yl1Ara/Ele2_smartmirror/README.md

Arttu Yli-Kujala, Aaro Esko and Eeva-Kaisa Kohonen
# ( ͡° ͜ʖ ͡°) tech. Smart Mirror

## Preview
The final_doc.pdf is the final documentation. It should be installed so all the links and \refs work

## Contribution
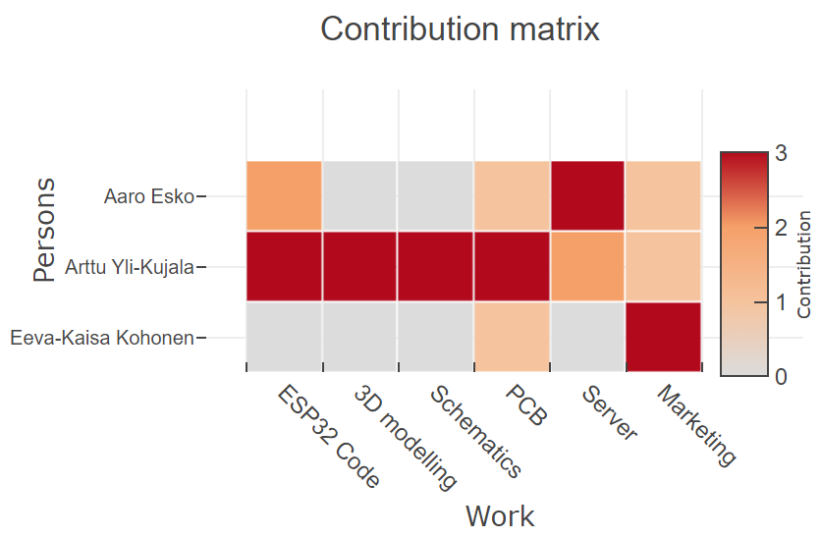
[picture p1: contributions.png]


## 3D modelling
GIF demo

## Schematics

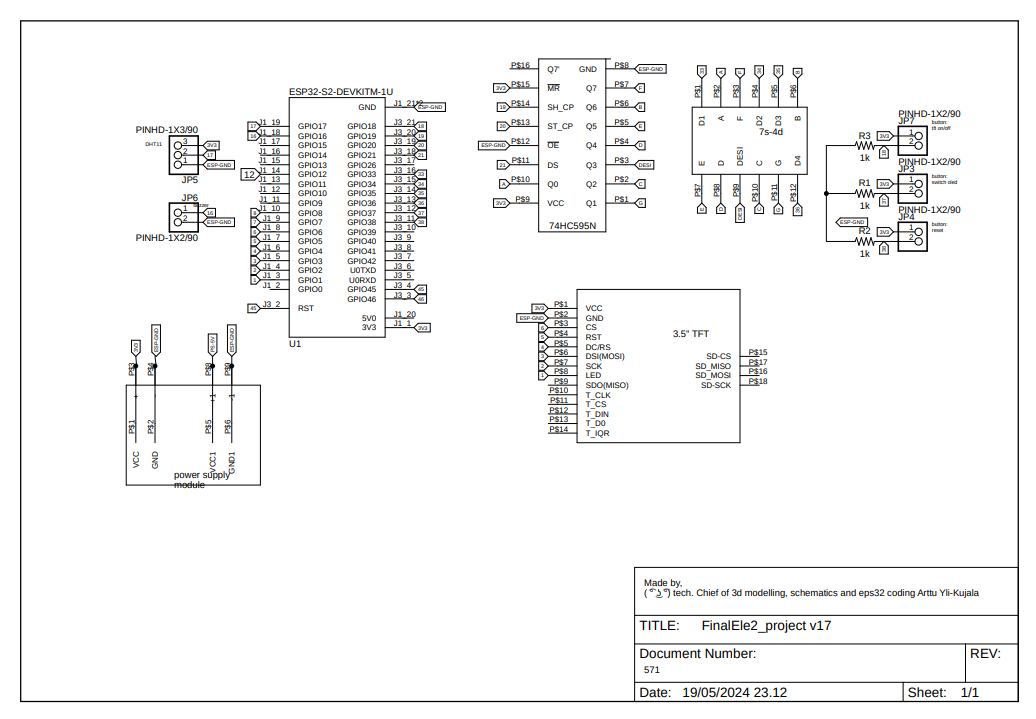
[picture p2: Schematics_and_PCB/Shematics/Schematics.png]


## PCB

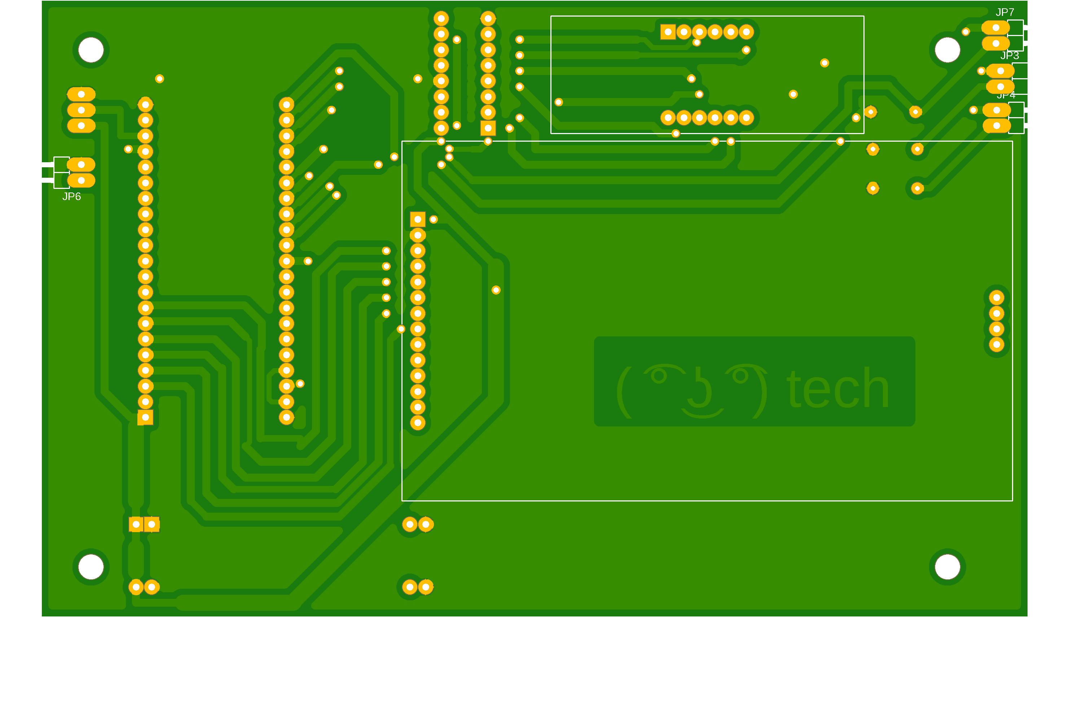
[picture p3: Schematics_and_PCB/PCB_layout/Topside.png]


## Server
