yl1Ara/Ele2_smartmirror/3Dmodel/Readme.txt

Here is included the main 3d model with all the parts that can be seen in the final product excluding wiring. These we used to make the 3d prints.

Included:
- .f3z which is the model in fusion 360 frame that includes desing and 3d animation that can be seen in the presentation,
- The .Step file looks slightly worse, but is more common and includes the same 3d model but not the animation.
- videos file consist of videos made with fusion 360 animated model presentation

Made by, 
( ͡° ͜ʖ ͡°) tech. Chief of 3d modelling, schematics and MCU coding Arttu Yli-Kujala
