yl1Ara/Ele2_smartmirror/Schematics_and_PCB/Shematics/Readme.txt

This file includes all the electronic schematics information

-.fsch is fusion 360 straight import with all the data about parts, their libraries and more info on connection and spices.
-schematics.pdf has a simple black and white picture of connections and parts
-schematics are also added in .png form

Made by, 
( ͡° ͜ʖ ͡°) tech. Chief of 3d modelling, schematics and MCU coding Arttu Yli-Kujala
