yl1Ara/Ele2_smartmirror/3Dmodel/videos/6.gif

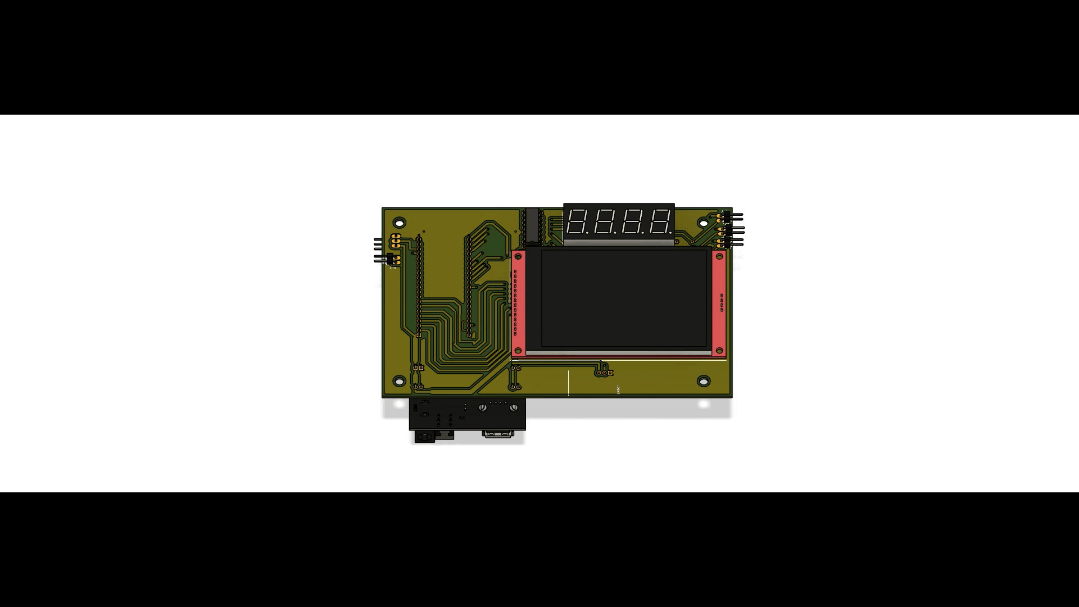
3Dmodel/videos/6.gif
