yl1Ara/Ele2_smartmirror/3Dmodel/videos/8.gif

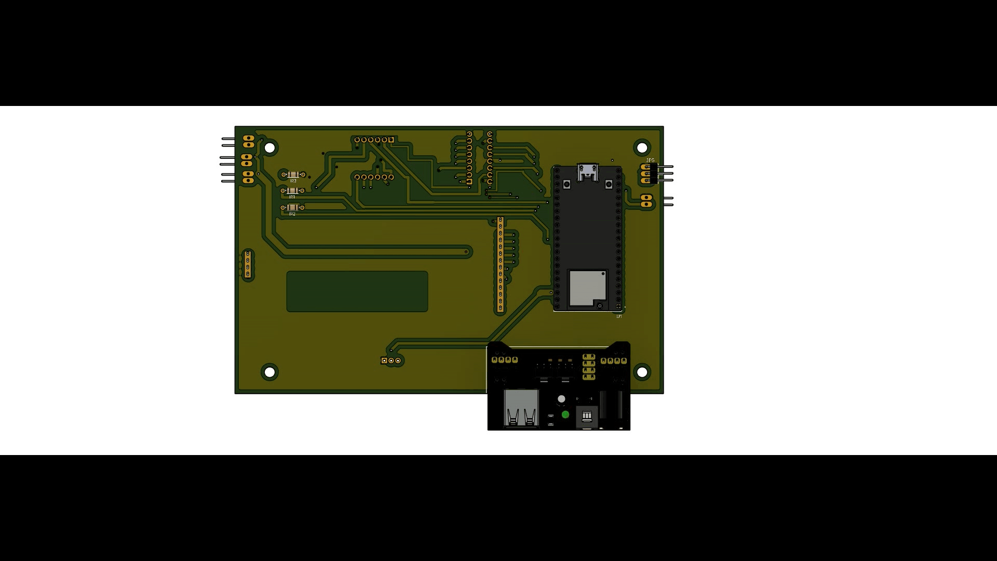
3Dmodel/videos/8.gif
