yl1Ara/Ele2_smartmirror/Schematics_and_PCB/Shematics/Schematics.pdf

3JP6

8 12

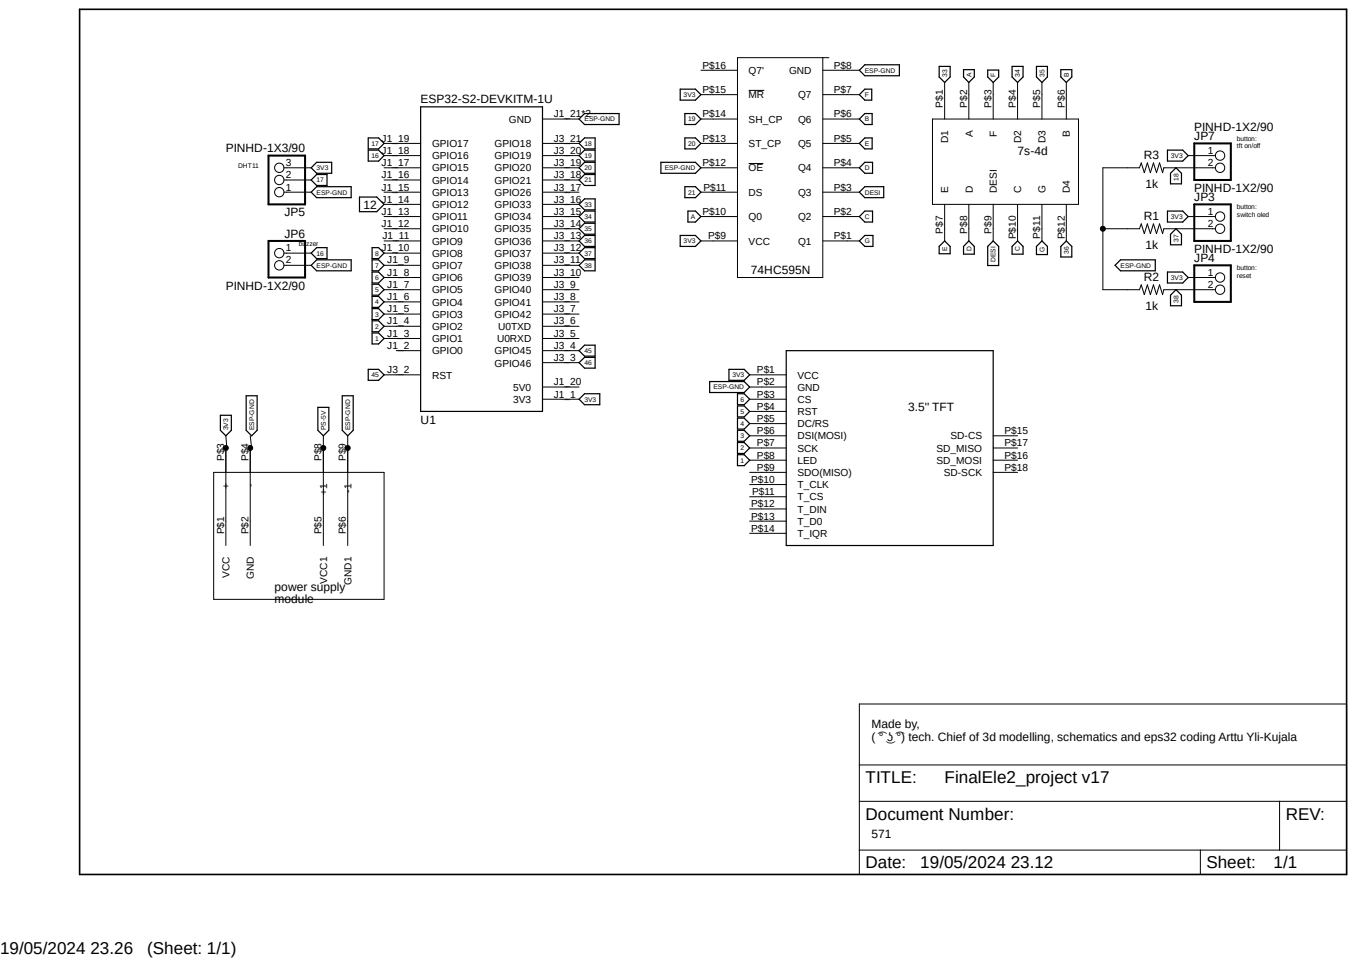
[picture p20: page 1]

Made by,
( ͡° ͜ʖ ͡°) tech. Chief of 3d modelling, schematics and eps32 coding Arttu Yli-Kujala

Document Number: 571 | REV:

Date: 19/05/2024 23.12 | Sheet: 1/1
