yl1Ara/Ele2_smartmirror/Schematics_and_PCB/PCB_layout/bot.pdf

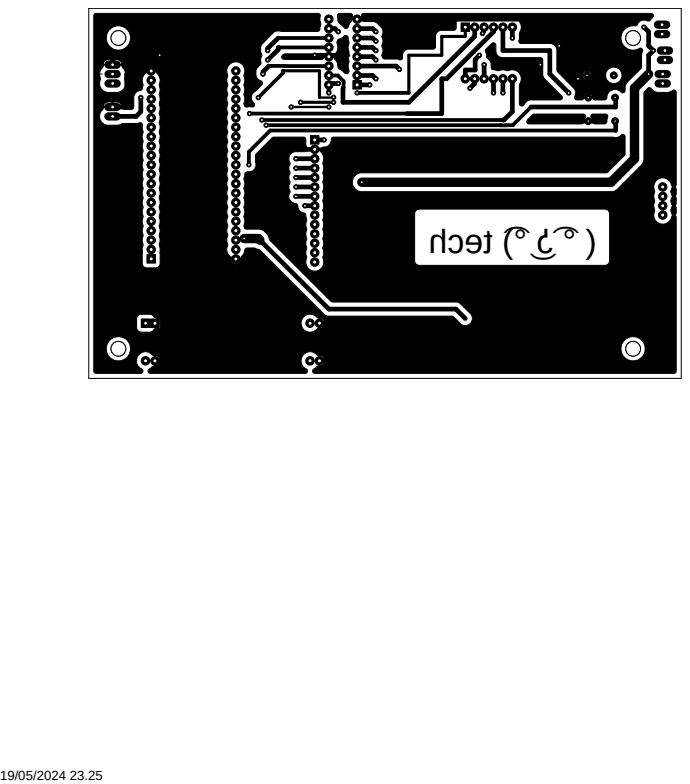
[picture p21: page 1]
