yl1Ara/Ele2_smartmirror/Schematics_and_PCB/PCB_layout/top.pdf

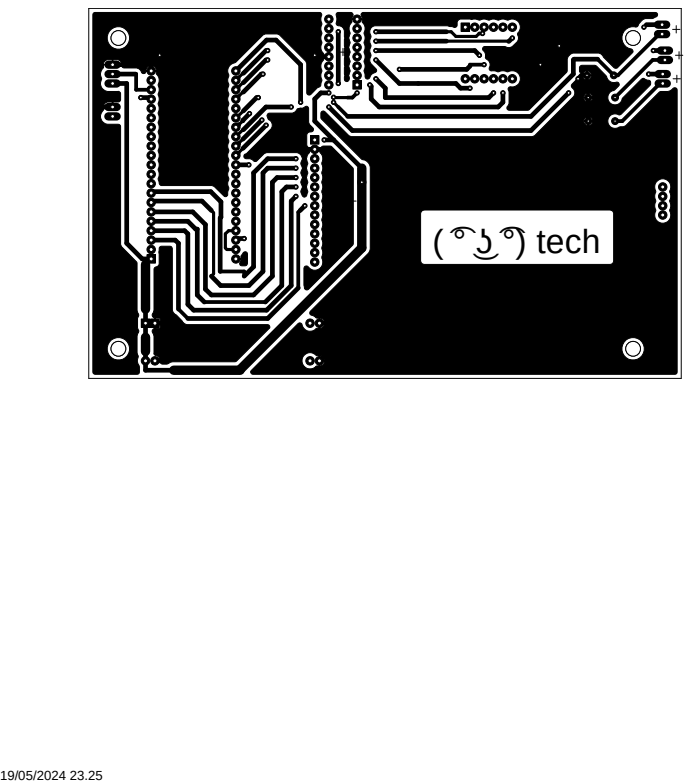
[picture p22: page 1]
( ͡° ͜ʖ ͡°) tech
