yl1Ara/Ele2_smartmirror/ESP32code/cloudy.h

// array size is 11894
static const byte cloudy[] PROGMEM  = {
  0x89, 0x50, 0x4e, 0x47, 0x0d, 0x0a, 0x1a, 0x0a, 0x00, 0x00, 0x00, 0x0d, 0x49, 0x48, 0x44, 0x52, 
  0x00, 0x00, 0x00, 0x3c, 0x00, 0x00, 0x00, 0x3c, 0x08, 0x06, 0x00, 0x00, 0x00, 0x3a, 0xfc, 0xd9, 
  0x72, 0x00, 0x00, 0x19, 0x30, 0x7a, 0x54, 0x58, 0x74, 0x52, 0x61, 0x77, 0x20, 0x70, 0x72, 0x6f, 
  0x66, 0x69, 0x6c, 0x65, 0x20, 0x74, 0x79, 0x70, 0x65, 0x20, 0x65, 0x78, 0x69, 0x66, 0x00, 0x00, 
  0x78, 0xda, 0xdd, 0x9b, 0x59, 0x96, 0x65, 0xb7, 0x71, 0x45, 0xff, 0x31, 0x0a, 0x0f, 0x01, 0x6d, 
  0x00, 0x18, 0x0e, 0xda, 0xb5, 0x3c, 0x03, 0x0f, 0xdf, 0xfb, 0xe0, 0x65, 0x95, 0x58, 0xc5, 0x12, 
  0x45, 0xd2, 0xf2, 0x8f, 0x2a, 0x95, 0x0d, 0x5f, 0x73, 0x2f, 0x10, 0xcd, 0x69, 0x02, 0x4f, 0xee, 
  0xfc, 0xcf, 0x7f, 0x5f, 0xf7, 0x5f, 0xfc, 0x33, 0xeb, 0xde, 0xe5, 0x52, 0x9b, 0x75, 0x33, 0xcf, 
  0xbf, 0xdc, 0x73, 0x8f, 0x83, 0x3f, 0x9a, 0xff, 0xfc, 0x1b, 0xef, 0x67, 0xf0, 0xf9, 0xfd, 0x7c, 
  0xff, 0xd2, 0xfa, 0x7a, 0x2e, 0xfc, 0xf8, 0xb8, 0xfb, 0xfe, 0x44, 0xe4, 0xa1, 0xa4, 0x57, 0x7e, 
  0xfe, 0xb3, 0xd9, 0xd7, 0xeb, 0xbf, 0x3d, 0x1e, 0xbe, 0x5f, 0xe0, 0xf3, 0x6b, 0xf0, 0x57, 0xf9, 
  0xcd, 0x85, 0xda, 0xd7, 0x85, 0xc2, 0xfc, 0xf1, 0x89, 0x9e, 0xbf, 0xae, 0xdf, 0x7e, 0xba, 0x50, 
  0xfc, 0x5a, 0x99, 0x56, 0xa4, 0xbf, 0xf7, 0xd7, 0x85, 0xfa, 0xd7, 0x85, 0x52, 0xfc, 0x3c, 0x11, 
  0xbe, 0x2e, 0x30, 0x3e, 0xdb, 0xf2, 0xd6, 0x5b, 0xfd, 0xed, 0x16, 0xe6, 0xf9, 0xfc, 0xfe, 0x7a, 
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
  0x8a, 0xa3, 0xa6, 0x9a, 0x5d, 0x2d, 0xd5, 0x6a, 0xad, 0xad, 0xf6, 0x3a, 0x5a, 0x6a, 0xb9, 0x95, 
  0x66, 0xad, 0xb6, 0xd6, 0x7a, 0x1b, 0x3d, 0xf6, 0x04, 0x68, 0x96, 0x6e, 0xbd, 0xf6, 0xd6, 0x7b, 
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
};
