yl1Ara/Ele2_smartmirror/ESP32code/fog.h

// array size is 6463
static const byte fog[] PROGMEM  = {
  0x89, 0x50, 0x4e, 0x47, 0x0d, 0x0a, 0x1a, 0x0a, 0x00, 0x00, 0x00, 0x0d, 0x49, 0x48, 0x44, 0x52, 
  0x00, 0x00, 0x00, 0x3c, 0x00, 0x00, 0x00, 0x3c, 0x08, 0x06, 0x00, 0x00, 0x00, 0x3a, 0xfc, 0xd9, 
  0x72, 0x00, 0x00, 0x09, 0x0a, 0x7a, 0x54, 0x58, 0x74, 0x52, 0x61, 0x77, 0x20, 0x70, 0x72, 0x6f, 
  0x66, 0x69, 0x6c, 0x65, 0x20, 0x74, 0x79, 0x70, 0x65, 0x20, 0x65, 0x78, 0x69, 0x66, 0x00, 0x00, 
  0x78, 0xda, 0xed, 0x59, 0x59, 0x92, 0xe3, 0x38, 0x0e, 0xfd, 0xe7, 0x29, 0xfa, 0x08, 0xdc, 0x40, 
  0x80, 0xc7, 0xe1, 0x1a, 0xd1, 0x37, 0x98, 0xe3, 0xcf, 0x03, 0x29, 0xb9, 0x65, 0xa7, 0xd3, 0xe9, 
  0xac, 0xac, 0x98, 0x88, 0xe9, 0x28, 0xbb, 0x52, 0x92, 0x29, 0x12, 0x00, 0xf1, 0xb0, 0xb2, 0xcc, 
  0xf8, 0xcf, 0xdf, 0xd3, 0xfc, 0x85, 0x4f, 0x74, 0x29, 0x9a, 0x48, 0x2c, 0x29, 0xa7, 0x64, 0xf1, 
  0x89, 0x39, 0x66, 0x5f, 0xf0, 0x20, 0x76, 0x7f, 0xca, 0xba, 0x3a, 0x1b, 0xd7, 0x75, 0x7d, 0x42, 
  0x3b, 0xde, 0xb9, 0xfb, 0x71, 0x73, 0x7b, 0xe1, 0x31, 0x14, 0x74, 0xe6, 0xfe, 0x29, 0xe9, 0x98, 
  0x7f, 0x8e, 0xbb, 0x1b, 0x81, 0x7d, 0x2b, 0x78, 0xa2, 0x0b, 0x21, 0x39, 0x08, 0xb9, 0x7a, 0xff, 
  0x22, 0xc7, 0x83, 0xbe, 0x3c, 0x10, 0xf2, 0x87, 0x64, 0x2a, 0x91, 0x3e, 0xf7, 0x83, 0x50, 0x3e, 
  0x08, 0x05, 0xbf, 0x5f, 0xb8, 0x83, 0x40, 0xd9, 0xdb, 0xb2, 0x29, 0x0b, 0x5f, 0xb7, 0x50, 0xc7, 
  0xbe, 0x1f, 0xeb, 0xb7, 0x1a, 0xf0, 0x67, 0xf4, 0x12, 0xe5, 0x5e, 0xec, 0x0f, 0xbf, 0x19, 0xda, 
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
  0xac, 0x2e, 0x98, 0x50, 0x4a, 0xf5, 0x35, 0xd4, 0x58, 0xc9, 0xd4, 0x54, 0xb9, 0x4a, 0xcd, 0xb5, 
  0x34, 0x98, 0x4f, 0x8b, 0x8d, 0x5a, 0x6a, 0xdc, 0xa4, 0xe5, 0x56, 0xba, 0xef, 0xa1, 0x23, 0x7e, 
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
};
