yl1Ara/Ele2_smartmirror/ESP32code/half_sunny.h

// array size is 14307
static const byte half_sunny[] PROGMEM  = {
  0x89, 0x50, 0x4e, 0x47, 0x0d, 0x0a, 0x1a, 0x0a, 0x00, 0x00, 0x00, 0x0d, 0x49, 0x48, 0x44, 0x52, 
  0x00, 0x00, 0x00, 0x3c, 0x00, 0x00, 0x00, 0x3c, 0x08, 0x06, 0x00, 0x00, 0x00, 0x3a, 0xfc, 0xd9, 
  0x72, 0x00, 0x00, 0x21, 0x93, 0x7a, 0x54, 0x58, 0x74, 0x52, 0x61, 0x77, 0x20, 0x70, 0x72, 0x6f, 
  0x66, 0x69, 0x6c, 0x65, 0x20, 0x74, 0x79, 0x70, 0x65, 0x20, 0x65, 0x78, 0x69, 0x66, 0x00, 0x00, 
  0x78, 0xda, 0xd5, 0x9c, 0x57, 0x76, 0x1d, 0x39, 0x96, 0x45, 0xff, 0x31, 0x8a, 0x1e, 0x02, 0xbc, 
  0x19, 0x0e, 0xec, 0x5a, 0x35, 0x83, 0x1e, 0x7e, 0xef, 0x83, 0x78, 0xa4, 0x48, 0x89, 0xaa, 0x4c, 
  0x99, 0x9f, 0x4e, 0x95, 0x48, 0xea, 0x99, 0x78, 0x88, 0x6b, 0x8e, 0xb9, 0x00, 0xcb, 0xec, 0xff, 
  0xfd, 0xcf, 0x31, 0xff, 0xc3, 0x7f, 0x35, 0x15, 0x6f, 0x62, 0x2a, 0x35, 0xb7, 0x9c, 0x2d, 0xff, 
  0xc5, 0x16, 0x9b, 0xef, 0xfc, 0x50, 0xed, 0xf3, 0x5f, 0xbf, 0x5f, 0x9d, 0x8d, 0xf7, 0xeb, 0xfd, 
  0x2f, 0xcc, 0xd7, 0x73, 0xee, 0xf3, 0xe3, 0xe6, 0xfd, 0x09, 0xcf, 0x43, 0x41, 0xaf, 0x7c, 0xfe, 
  0x59, 0xf3, 0xeb, 0xf5, 0x6f, 0x8f, 0xbb, 0xf7, 0x0b, 0x3c, 0xdf, 0x3a, 0x3f, 0xa5, 0x0f, 0x17, 
  0xaa, 0xaf, 0x0b, 0xb9, 0xf1, 0xf9, 0x89, 0x16, 0x5f, 0xd7, 0xaf, 0xdf, 0x5d, 0xc8, 0xbf, 0x56, 
  0xa6, 0x15, 0xe9, 0xe7, 0xf5, 0xba, 0x50, 0x7b, 0x5d, 0x28, 0xf8, 0xe7, 0x09, 0xf7, 0xba, 0x40, 
  0x7f, 0x6e, 0xcb, 0xe6, 0x56, 0xcb, 0xc7, 0x5b, 0x18, 0xfb, 0xf9, 0xfe, 0x7a, 0xff, 0x13, 0x06, 
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
  0x4a, 0x34, 0x25, 0x95, 0x5c, 0x4a, 0xa9, 0xa5, 0x95, 0x5e, 0x43, 0x8d, 0x35, 0xd5, 0x5c, 0x4b, 
  0xad, 0xb5, 0xd5, 0xde, 0x7c, 0x0b, 0x80, 0x66, 0x6a, 0xb9, 0x95, 0x56, 0x5b, 0x6b, 0xbd, 0xf3, 
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
};
