yl1Ara/Ele2_smartmirror/ESP32code/rain.h

// array size is 13938
static const byte rain[] PROGMEM  = {
  0x89, 0x50, 0x4e, 0x47, 0x0d, 0x0a, 0x1a, 0x0a, 0x00, 0x00, 0x00, 0x0d, 0x49, 0x48, 0x44, 0x52, 
  0x00, 0x00, 0x00, 0x3c, 0x00, 0x00, 0x00, 0x3c, 0x08, 0x06, 0x00, 0x00, 0x00, 0x3a, 0xfc, 0xd9, 
  0x72, 0x00, 0x00, 0x20, 0xcc, 0x7a, 0x54, 0x58, 0x74, 0x52, 0x61, 0x77, 0x20, 0x70, 0x72, 0x6f, 
  0x66, 0x69, 0x6c, 0x65, 0x20, 0x74, 0x79, 0x70, 0x65, 0x20, 0x65, 0x78, 0x69, 0x66, 0x00, 0x00, 
  0x78, 0xda, 0xa5, 0x9b, 0xe9, 0x75, 0x1c, 0xb9, 0x92, 0x85, 0xff, 0xc3, 0x8a, 0x31, 0x01, 0xfb, 
  0x62, 0x0e, 0xd6, 0x73, 0xc6, 0x83, 0x31, 0x7f, 0xbe, 0x8b, 0x4c, 0xf2, 0x91, 0x92, 0xba, 0x9f, 
  0xd4, 0xad, 0x8d, 0x54, 0x31, 0x2b, 0x13, 0x40, 0x44, 0xdc, 0x25, 0x80, 0x32, 0xfb, 0xff, 0xfe, 
  0xf7, 0x98, 0xff, 0xe1, 0x57, 0x0d, 0xd6, 0x9a, 0x98, 0x4a, 0xcd, 0x2d, 0x67, 0xcb, 0xaf, 0xd8, 
  0x62, 0xf3, 0x9d, 0x6f, 0xaa, 0x7d, 0x7e, 0xf5, 0xfb, 0xaf, 0xb3, 0xf1, 0xfe, 0x7b, 0x7f, 0x85, 
  0xf9, 0xfe, 0xcc, 0x7d, 0x7f, 0xdd, 0x7c, 0xfe, 0xc0, 0xf3, 0x52, 0xd0, 0x95, 0xcf, 0x7f, 0x6b, 
  0x7e, 0xaf, 0xff, 0x78, 0xdd, 0x7d, 0xde, 0xe0, 0xf9, 0xd2, 0xf9, 0x2e, 0x7d, 0xb9, 0x51, 0x7d, 
  0x6f, 0xe4, 0xc6, 0xf7, 0x1f, 0xb4, 0xf8, 0xde, 0xbf, 0xfe, 0x70, 0x23, 0xff, 0x8e, 0x4c, 0x23, 
  0xd2, 0xf7, 0xeb, 0xbd, 0x51, 0x7b, 0x6f, 0x14, 0xfc, 0xf3, 0x03, 0xf7, 0xde, 0xa0, 0x3f, 0xd3, 
  0xb2, 0xb9, 0xd5, 0xf2, 0x75, 0x0a, 0x63, 0x3f, 0x5f, 0xdf, 0xf7, 0x3f, 0xcb, 0xc0, 0x5f, 0xa3, 
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
  0x4a, 0xa9, 0xa5, 0x95, 0x5e, 0x43, 0x8d, 0x35, 0xd5, 0x5c, 0x4b, 0xad, 0xb5, 0xd5, 0xde, 0x7c, 
  0x0b, 0x80, 0x66, 0x6a, 0xb9, 0x95, 0x56, 0x5b, 0x6b, 0xbd, 0xf3, 0xcc, 0xce, 0x9d, 0x3b, 0xef, 
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
};
