yl1Ara/Ele2_smartmirror/ESP32code/snow.h

// array size is 16528
static const byte snow[] PROGMEM  = {
  0x89, 0x50, 0x4e, 0x47, 0x0d, 0x0a, 0x1a, 0x0a, 0x00, 0x00, 0x00, 0x0d, 0x49, 0x48, 0x44, 0x52, 
  0x00, 0x00, 0x00, 0x3c, 0x00, 0x00, 0x00, 0x3c, 0x08, 0x06, 0x00, 0x00, 0x00, 0x3a, 0xfc, 0xd9, 
  0x72, 0x00, 0x00, 0x29, 0x36, 0x7a, 0x54, 0x58, 0x74, 0x52, 0x61, 0x77, 0x20, 0x70, 0x72, 0x6f, 
  0x66, 0x69, 0x6c, 0x65, 0x20, 0x74, 0x79, 0x70, 0x65, 0x20, 0x65, 0x78, 0x69, 0x66, 0x00, 0x00, 
  0x78, 0xda, 0xb5, 0x9c, 0x69, 0x96, 0x5c, 0xc9, 0x8e, 0x9c, 0xff, 0xfb, 0x2a, 0xb4, 0x04, 0x9f, 
  0x87, 0xe5, 0xf8, 0x78, 0x8e, 0x76, 0xa0, 0xe5, 0xeb, 0x33, 0x44, 0x30, 0x6b, 0xe2, 0xeb, 0xee, 
  0xa7, 0x6e, 0x15, 0x8b, 0x4c, 0x32, 0x33, 0xf2, 0xc6, 0xbd, 0x18, 0x0c, 0x66, 0x00, 0x3c, 0xdd, 
  0xfd, 0x3f, 0xff, 0xfb, 0xb9, 0xff, 0xc5, 0x7f, 0xa3, 0x8f, 0xea, 0x72, 0x69, 0xbd, 0x8e, 0x5a, 
  0x3d, 0xff, 0xe5, 0x91, 0x47, 0x9c, 0xfc, 0xa5, 0xfb, 0xcf, 0x7f, 0xd3, 0xfe, 0x0c, 0x3e, 0xdb, 
  0x9f, 0xf6, 0x5f, 0xda, 0xdf, 0xaf, 0x85, 0xbf, 0x7e, 0xde, 0xfd, 0x7c, 0x21, 0xf2, 0xa9, 0xa4, 
  0x57, 0x7e, 0xfe, 0xd9, 0xeb, 0xf7, 0xf5, 0xbf, 0x3e, 0x1f, 0x7e, 0x2e, 0xf0, 0xf9, 0x30, 0xf9, 
  0x5b, 0xf9, 0xd3, 0x85, 0xfa, 0xf7, 0x42, 0x61, 0xfd, 0xf5, 0x0b, 0x23, 0x7f, 0xaf, 0xdf, 0xff, 
  0x76, 0xa1, 0xf8, 0xbd, 0x33, 0xdd, 0x91, 0xfe, 0x7e, 0xbe, 0x17, 0x1a, 0xdf, 0x0b, 0xa5, 0xf8, 
  0xf9, 0x42, 0xf8, 0x5e, 0x60, 0x7e, 0x1e, 0xcb, 0xd7, 0xd1, 0xdb, 0x9f, 0x1f, 0x61, 0xdd, 0xcf, 
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
  0x66, 0x4d, 0x35, 0xd7, 0x52, 0x6b, 0x6d, 0x55, 0xa0, 0x38, 0x5b, 0x6a, 0xd9, 0xb5, 0xd2, 0x6a, 
  0x6b, 0xad, 0xb7, 0xd1, 0x66, 0x4f, 0x3d, 0xf7, 0xd2, 0x6b, 0x6f, 0xbd, 0xf7, 0xd1, 0xe7, 0x88, 
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
};
