yl1Ara/Ele2_smartmirror/ESP32code/sunny.h

// array size is 15347
static const byte sunny[] PROGMEM  = {
  0x89, 0x50, 0x4e, 0x47, 0x0d, 0x0a, 0x1a, 0x0a, 0x00, 0x00, 0x00, 0x0d, 0x49, 0x48, 0x44, 0x52, 
  0x00, 0x00, 0x00, 0x3c, 0x00, 0x00, 0x00, 0x3c, 0x08, 0x06, 0x00, 0x00, 0x00, 0x3a, 0xfc, 0xd9, 
  0x72, 0x00, 0x00, 0x25, 0xe6, 0x7a, 0x54, 0x58, 0x74, 0x52, 0x61, 0x77, 0x20, 0x70, 0x72, 0x6f, 
  0x66, 0x69, 0x6c, 0x65, 0x20, 0x74, 0x79, 0x70, 0x65, 0x20, 0x65, 0x78, 0x69, 0x66, 0x00, 0x00, 
  0x78, 0xda, 0xa5, 0x9c, 0x69, 0x76, 0x24, 0xb7, 0x72, 0x85, 0xff, 0x63, 0x15, 0x5e, 0x42, 0x62, 
  0x06, 0x96, 0x03, 0x20, 0x80, 0x73, 0xbc, 0x03, 0x2f, 0xdf, 0xdf, 0x45, 0x16, 0xd9, 0x83, 0xd4, 
  0xcf, 0x4f, 0x7e, 0x6a, 0xa9, 0x49, 0x16, 0xab, 0x32, 0x31, 0x44, 0xdc, 0x21, 0x10, 0x29, 0xb7, 
  0xff, 0xe7, 0xbf, 0x8f, 0xfb, 0x2f, 0xfe, 0xe9, 0x3e, 0x07, 0x97, 0x72, 0x6d, 0xa5, 0x97, 0xf2, 
  0xf0, 0x4f, 0xea, 0xa9, 0x87, 0xc1, 0x37, 0xed, 0x79, 0xff, 0x19, 0xf7, 0x6f, 0xff, 0xa4, 0xfb, 
  0xf7, 0xfd, 0x27, 0xae, 0xcf, 0xef, 0xfc, 0xaf, 0xaf, 0xbb, 0xef, 0x5f, 0x04, 0x5e, 0x8a, 0x7a, 
  0xe7, 0xfb, 0x63, 0x2b, 0x9f, 0xf7, 0x7f, 0xbd, 0xee, 0xbf, 0x2f, 0xf0, 0x7e, 0x19, 0x7c, 0x97, 
  0x7f, 0xba, 0x50, 0xfb, 0x5c, 0xc8, 0xcf, 0x5f, 0x7f, 0xd1, 0xd3, 0xe7, 0xfa, 0xed, 0xb7, 0x0b, 
  0x85, 0xcf, 0xc8, 0x34, 0x22, 0x7d, 0x6f, 0x9f, 0x0b, 0xf5, 0xcf, 0x85, 0x62, 0x78, 0x7f, 0xe1, 
  0x3f, 0x17, 0x18, 0xef, 0xb4, 0x9e, 0xd2, 0x5b, 0xfd, 0x79, 0x0a, 0x73, 0xbf, 0x5f, 0x3f, 0x9f, 
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
  0xe4, 0x52, 0x4a, 0x2d, 0x02, 0xc5, 0x51, 0x63, 0x4d, 0xae, 0xe6, 0x5a, 0x6a, 0xad, 0xad, 0xf6, 
  0x3a, 0x5a, 0x6c, 0xa9, 0xe5, 0x56, 0x5a, 0x6d, 0xad, 0xf5, 0x36, 0x7a, 0xe8, 0x11, 0xd0, 0xcc, 
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
};
