yl1Ara/Ele2_smartmirror/ESP32code/thunder.h

// array size is 12561
static const byte thunder[] PROGMEM  = {
  0x89, 0x50, 0x4e, 0x47, 0x0d, 0x0a, 0x1a, 0x0a, 0x00, 0x00, 0x00, 0x0d, 0x49, 0x48, 0x44, 0x52, 
  0x00, 0x00, 0x00, 0x3c, 0x00, 0x00, 0x00, 0x3c, 0x08, 0x06, 0x00, 0x00, 0x00, 0x3a, 0xfc, 0xd9, 
  0x72, 0x00, 0x00, 0x1c, 0x80, 0x7a, 0x54, 0x58, 0x74, 0x52, 0x61, 0x77, 0x20, 0x70, 0x72, 0x6f, 
  0x66, 0x69, 0x6c, 0x65, 0x20, 0x74, 0x79, 0x70, 0x65, 0x20, 0x65, 0x78, 0x69, 0x66, 0x00, 0x00, 
  0x78, 0xda, 0xad, 0x9b, 0x69, 0x76, 0x5c, 0x37, 0x92, 0x85, 0xff, 0x63, 0x15, 0xbd, 0x04, 0x4c, 
  0x81, 0x61, 0x39, 0x18, 0xcf, 0xe9, 0x1d, 0xf4, 0xf2, 0xfb, 0xbb, 0x48, 0x4a, 0x65, 0xc9, 0xaa, 
  0x72, 0xa9, 0xca, 0xa2, 0xc9, 0x24, 0x33, 0xdf, 0x80, 0x87, 0x88, 0xb8, 0x43, 0x00, 0x76, 0xe7, 
  0xff, 0xfe, 0xf7, 0xba, 0xff, 0xe1, 0x5f, 0x8d, 0xbe, 0xb8, 0x6c, 0xb5, 0x95, 0x5e, 0x8a, 0xe7, 
  0x5f, 0xee, 0xb9, 0xc7, 0xc1, 0x2f, 0xcd, 0x7f, 0xfe, 0x8d, 0xf7, 0x33, 0xf8, 0xfc, 0x7e, 0xbe, 
  0x7f, 0x69, 0x7d, 0x7d, 0x16, 0x7e, 0x7c, 0xdf, 0x7d, 0xff, 0x20, 0xf2, 0x56, 0xd2, 0x91, 0x9f, 
  0x3f, 0x5b, 0xf9, 0x3a, 0xfe, 0xdb, 0xfb, 0xe1, 0xfb, 0x05, 0x3e, 0x2f, 0x83, 0xdf, 0xec, 0x0f, 
  0x17, 0x6a, 0x5f, 0x17, 0x0a, 0xf3, 0xc7, 0x0f, 0x7a, 0xfe, 0xba, 0x7e, 0xfb, 0xe9, 0x42, 0xf1, 
  0x6b, 0x64, 0x1a, 0x91, 0x7e, 0xdf, 0x5f, 0x17, 0xea, 0x5f, 0x17, 0x4a, 0xf1, 0xf3, 0x41, 0xf8, 
  0xba, 0xc0, 0xf8, 0x3c, 0x96, 0x2f, 0xbd, 0xd5, 0x3f, 0x3e, 0xc2, 0x3c, 0x9f, 0xd7, 0xaf, 0xf3, 
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
  0xd9, 0x55, 0xab, 0xa5, 0xd6, 0xda, 0x6a, 0xaf, 0xa3, 0xa5, 0x96, 0x9b, 0xb5, 0xd2, 0x6a, 0x6b, 
  0xad, 0xb7, 0xd1, 0x63, 0x4f, 0x80, 0xa6, 0xf5, 0xd2, 0x6b, 0x6f, 0xbd, 0xf7, 0x31, 0xb8, 0xe7, 
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
};
