yl1Ara/Ele2_smartmirror/(commit log)

2024-05-19 ESP32 code
    updated comments
2024-05-19 ESP32 code
    Added pitches.h
2024-05-19 ESP32 code
    Included TFT_eSPI library changes and added Readme.txt
2024-05-19 Schematics and PCB
    added info to PCB
2024-05-19 Schematics and PCB
    Added Schematics info
2024-05-26 Presentation
    added powerpoint
